STARS-Design-Track-2023/Teenage-Mixing-Ninja-Turtles/docs/pinout.drawio.png

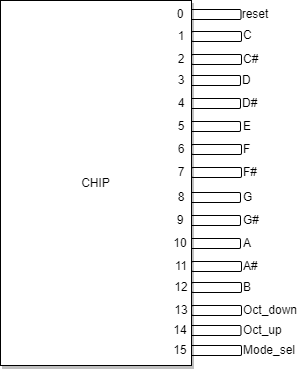
docs/pinout.drawio.png
