STARS-Design-Track-2023/Teenage-Mixing-Ninja-Turtles/docs/Scankey.drawio.png

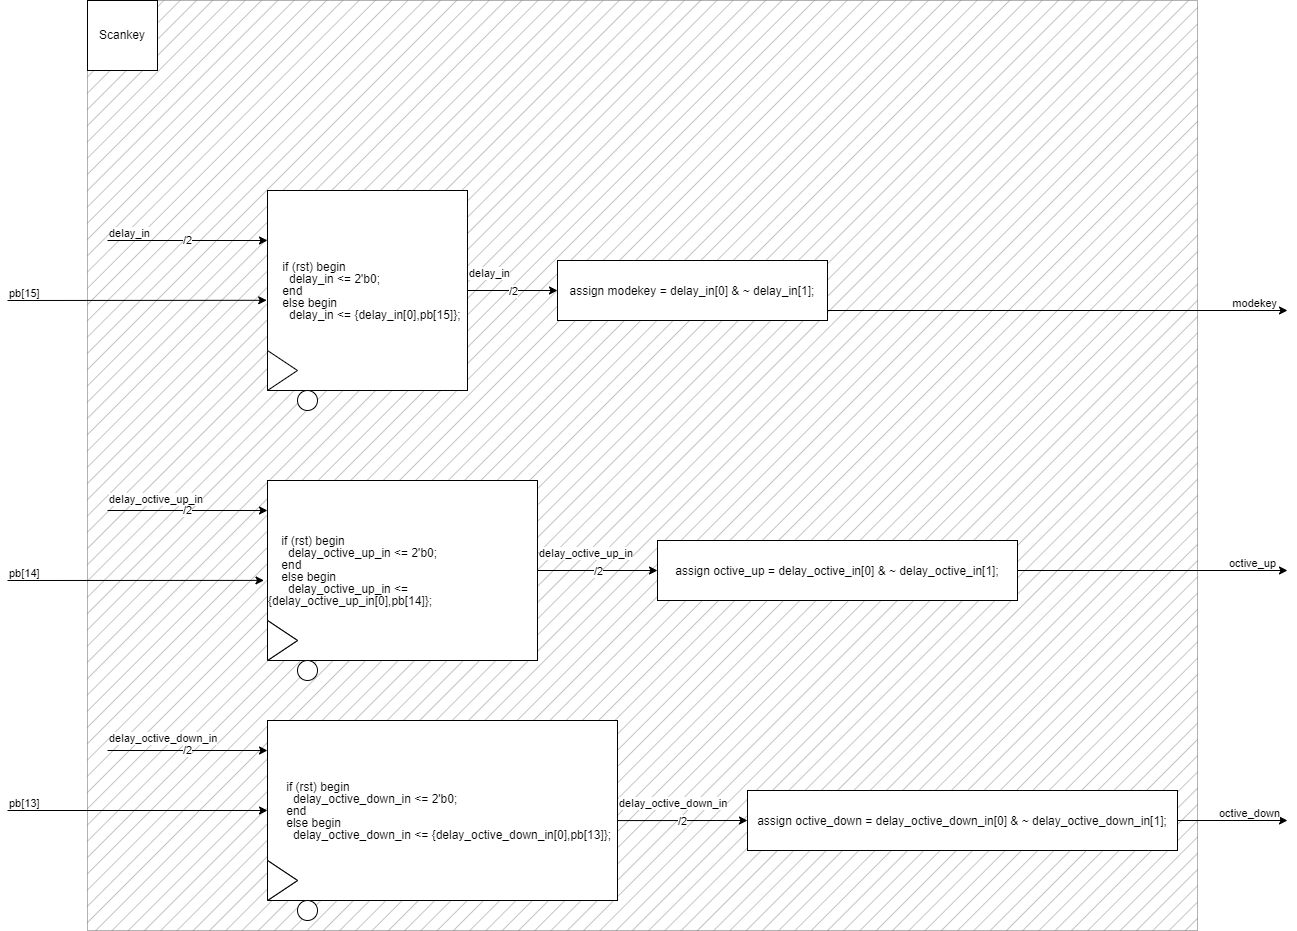
docs/Scankey.drawio.png
