STARS-Design-Track-2023/Teenage-Mixing-Ninja-Turtles/docs/STARS Design Review.pdf

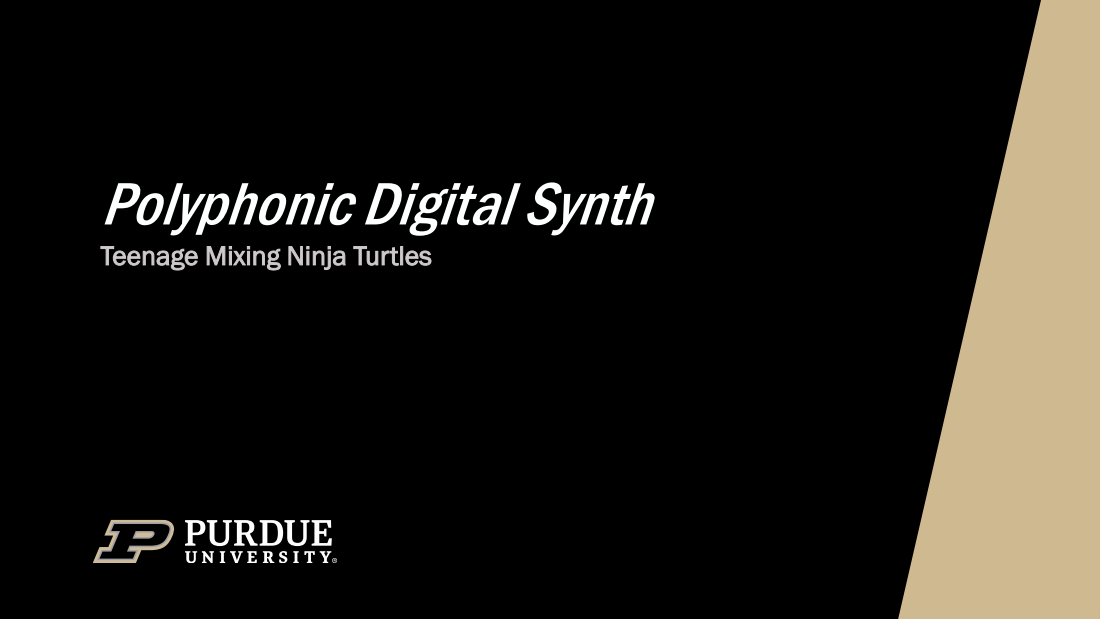
[picture p16: page 1]

Polyphonic Digital Synth

Teenage Mixing Ninja Turtles

# Goal of the Design

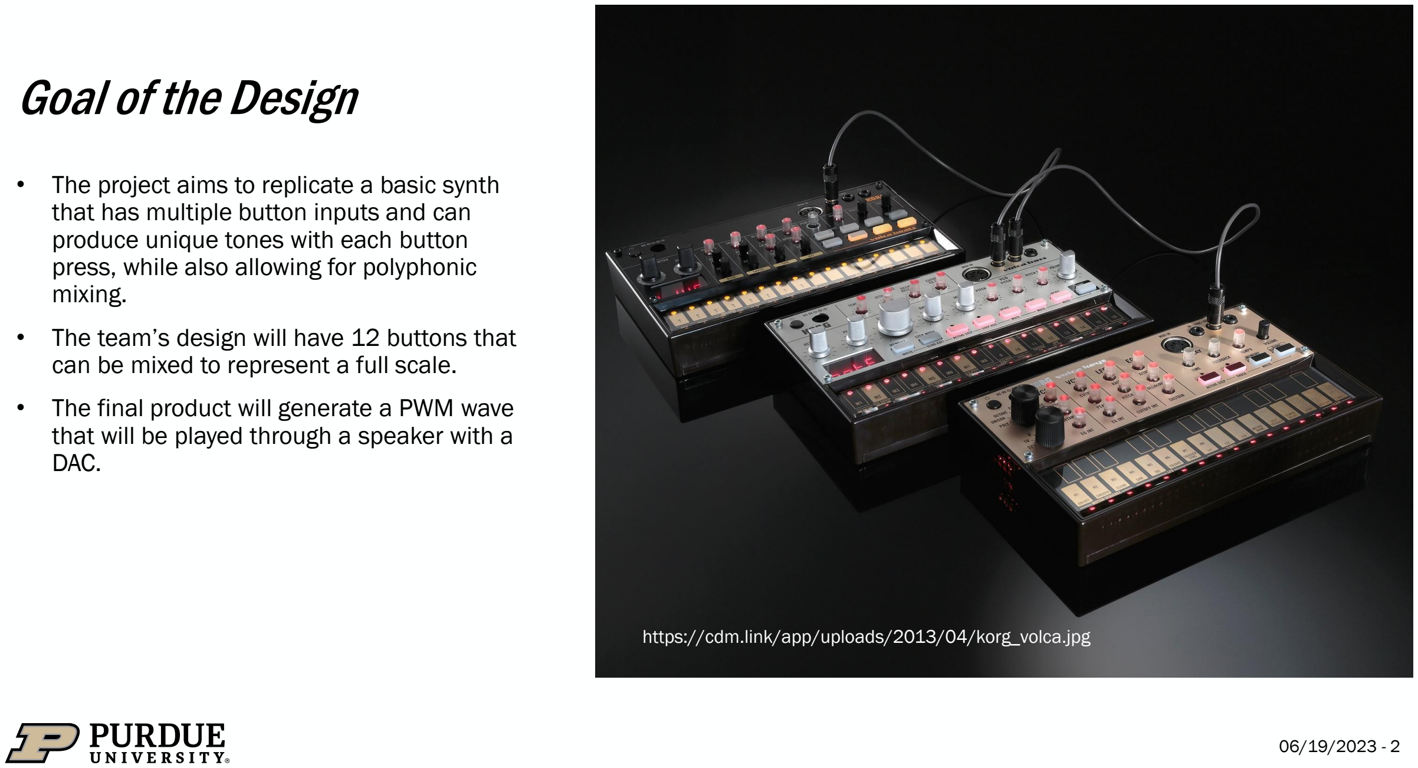
[picture p17: page 2]

- The project aims to replicate a basic synth that has multiple button inputs and can produce unique tones with each button press, while also allowing for polyphonic mixing.
- The team’s design will have 12 buttons that can be mixed to represent a full scale.
- The final product will generate a PWM wave that will be played through a speaker with a DAC.

https://cdm.link/app/uploads/2013/04/korg_volca.jpg

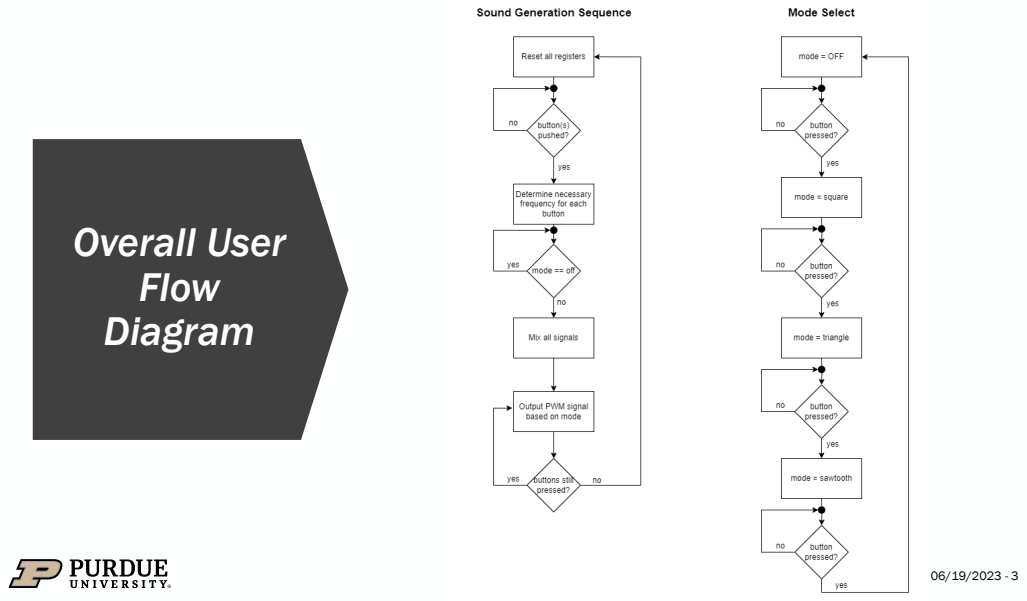
[picture p18: page 3]
Overall User Flow Diagram

Overview | RTL Diagram

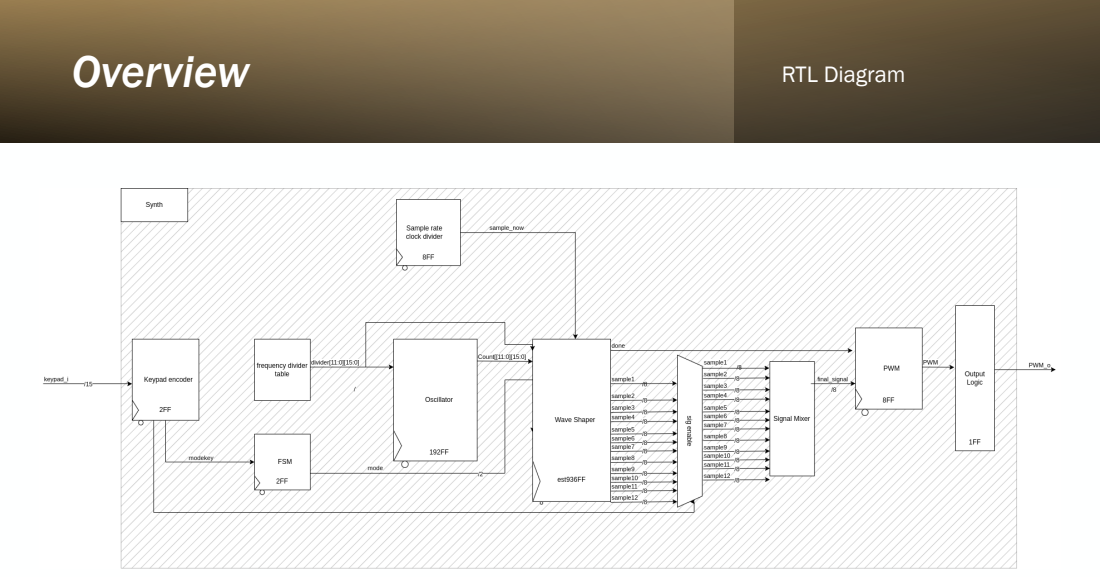
[picture p19: page 4]

Keypad | RTL

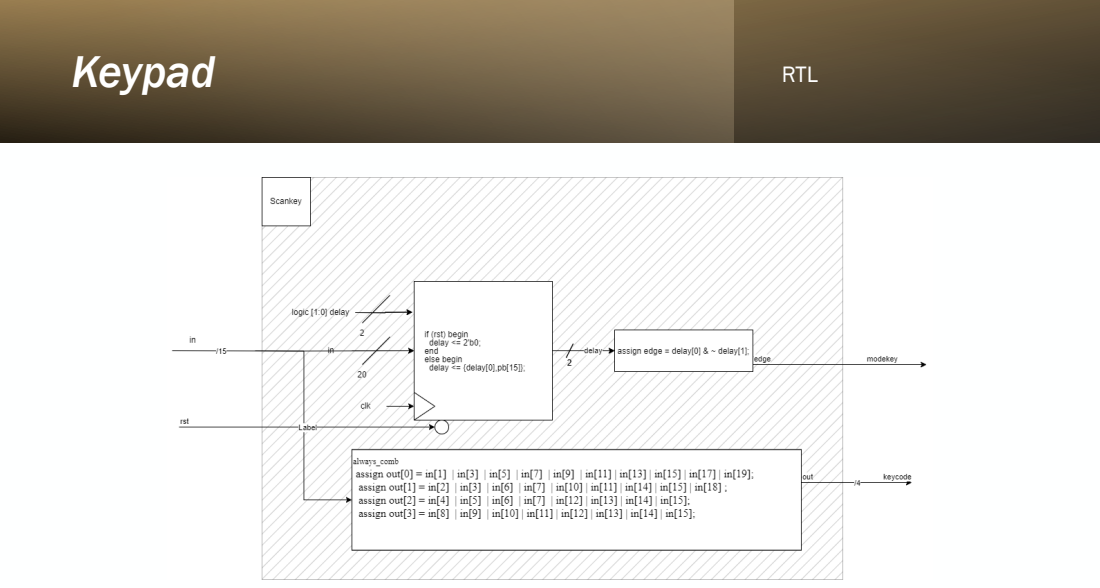
[picture p20: page 5]

Keypad | Wavedrom

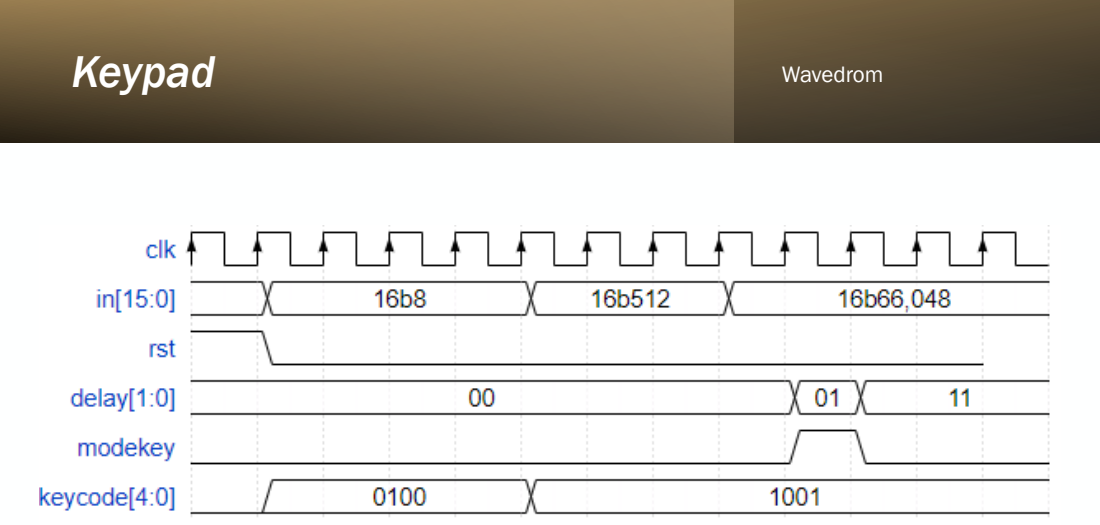
[picture p21: page 6]

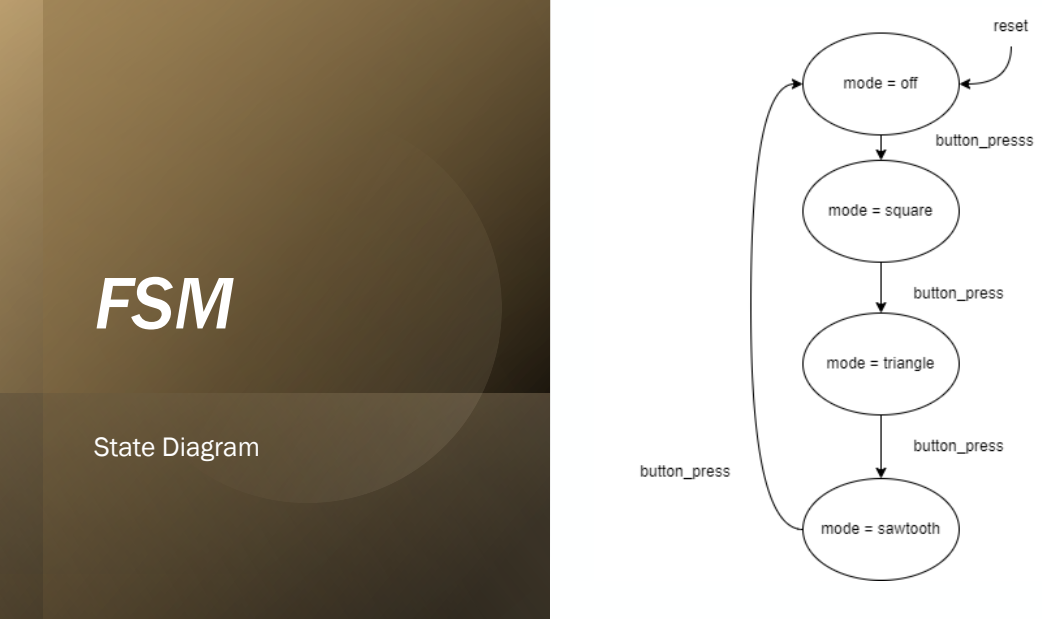
[picture p22: page 7]
FSM; State Diagram

# FSM

## Register

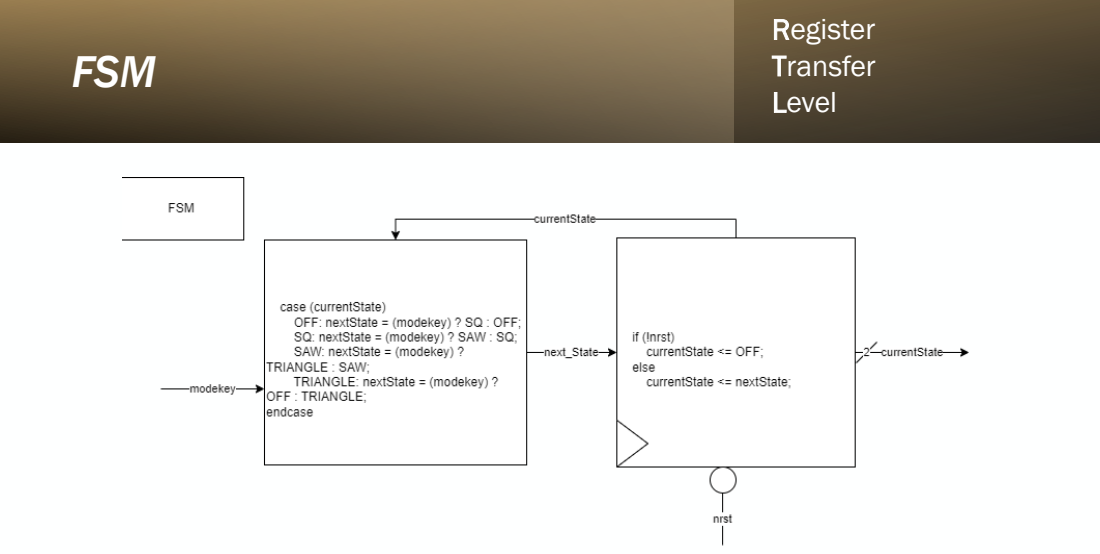
[picture p23: page 8]
Transfer Level

Oscillator | RTL

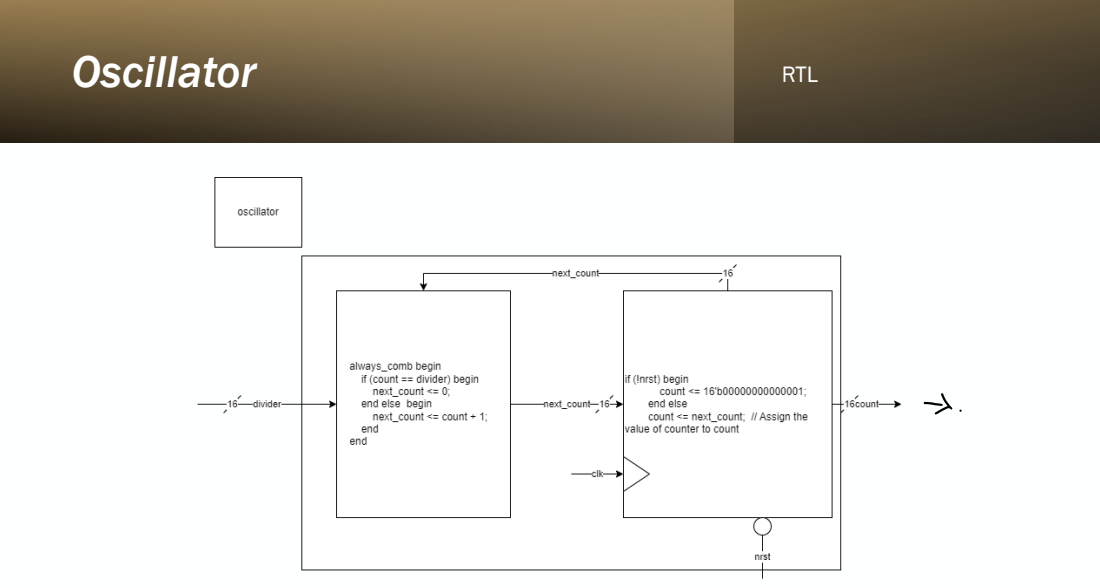
[picture p24: page 9]

Oscillator | Wavedrom

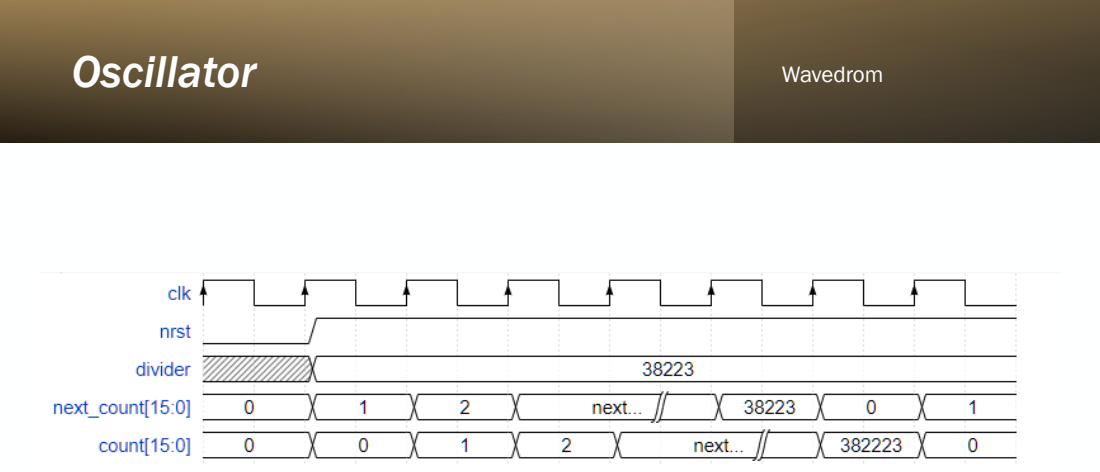
[picture p25: page 10]

Sample Rate ClkDiv | RTL

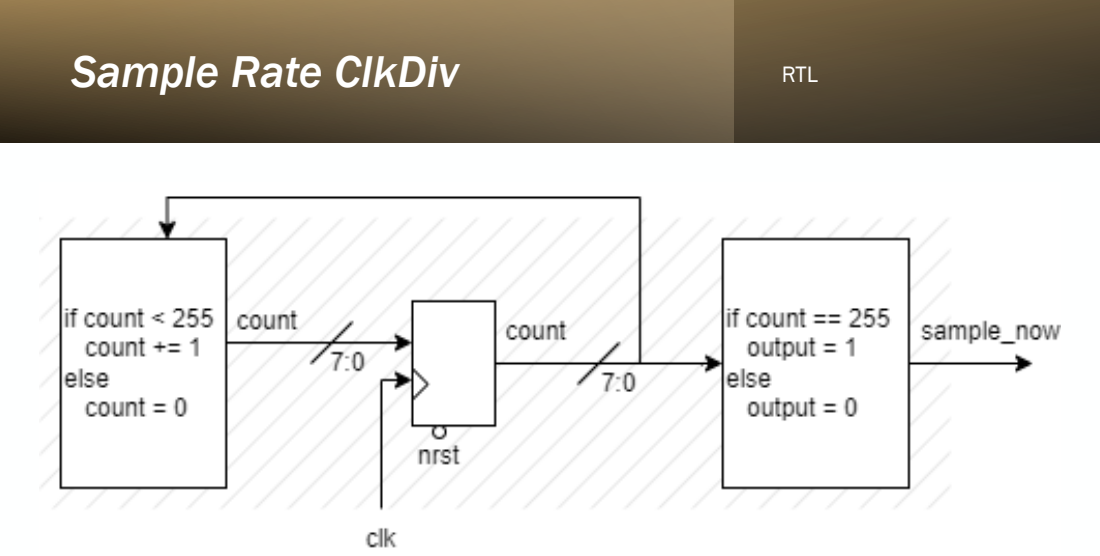
[picture p26: page 11]

# Sample Rate ClkDiv

## Wavedrom

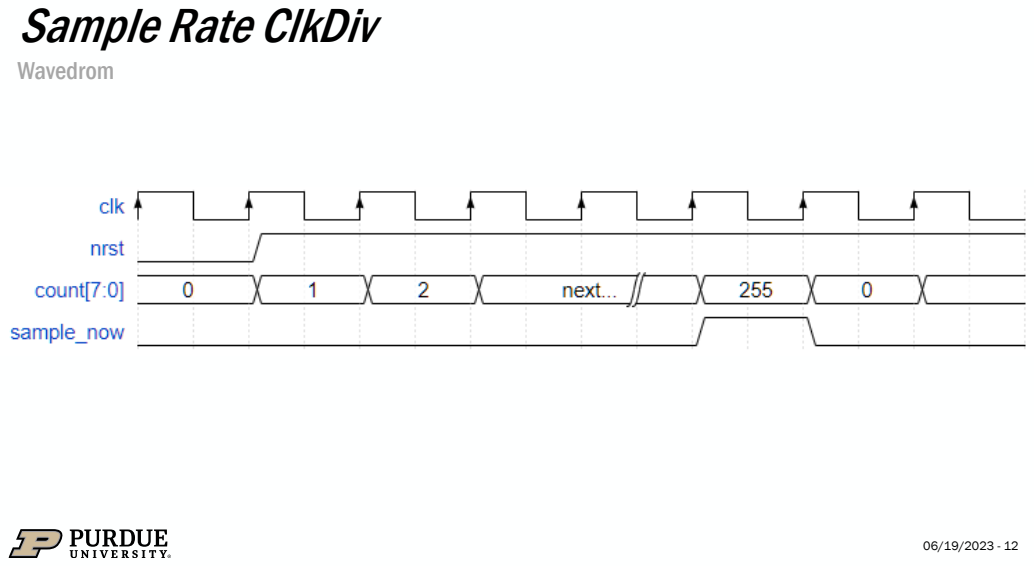
[picture p27: page 12]

# Wave Shaper

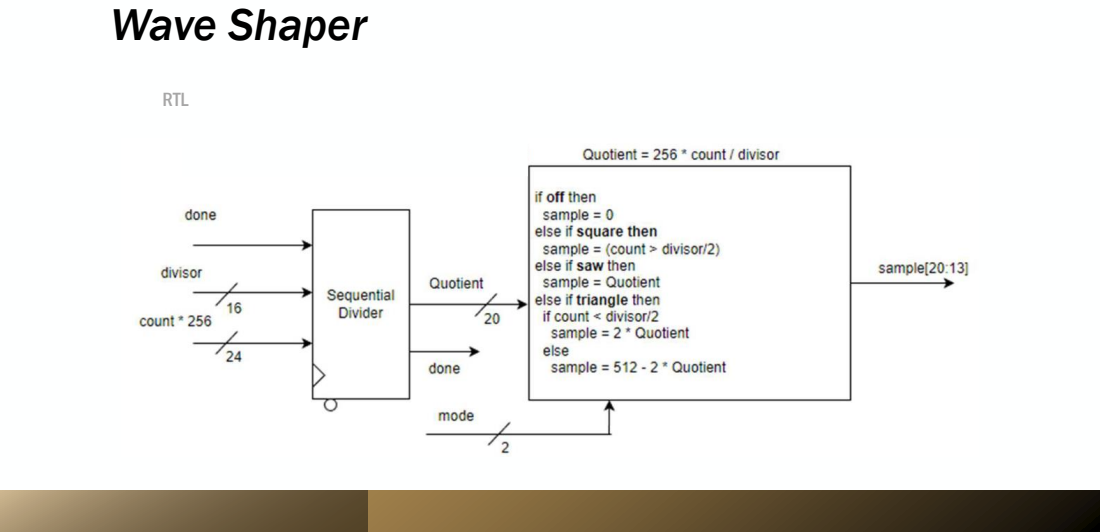
[picture p28: page 13]
RTL

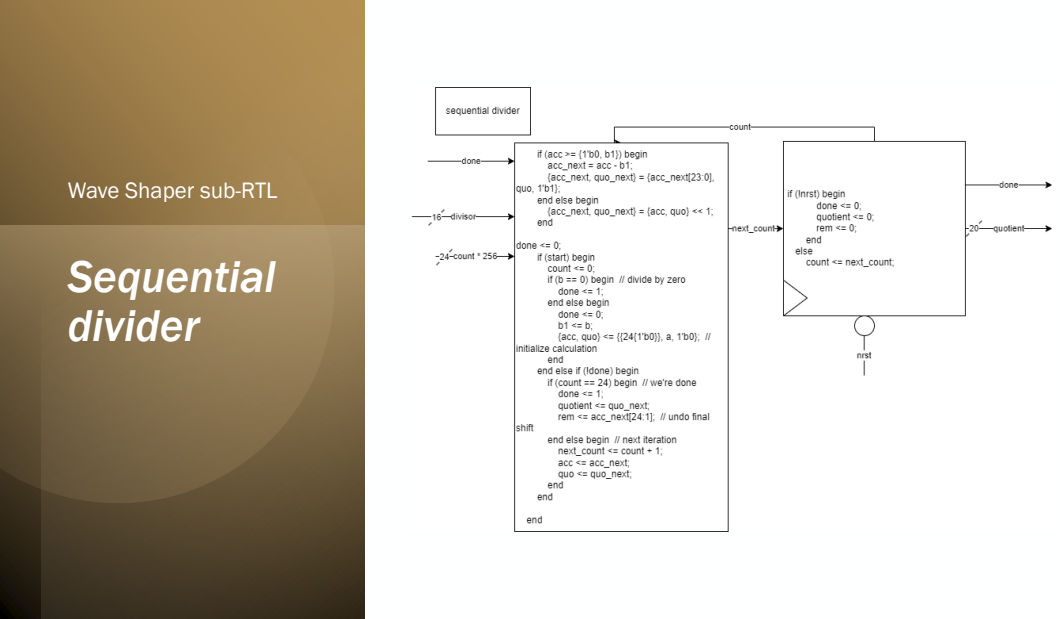
[picture p29: page 14]
Sequential divider

Wave Shaper sub-RTL

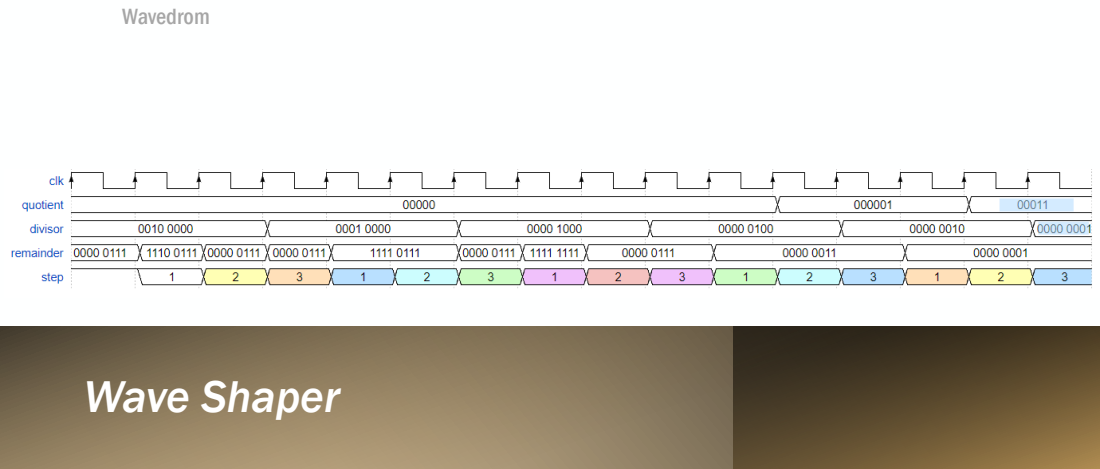
[picture p30: page 15]
Wave Shaper; Wavedrom

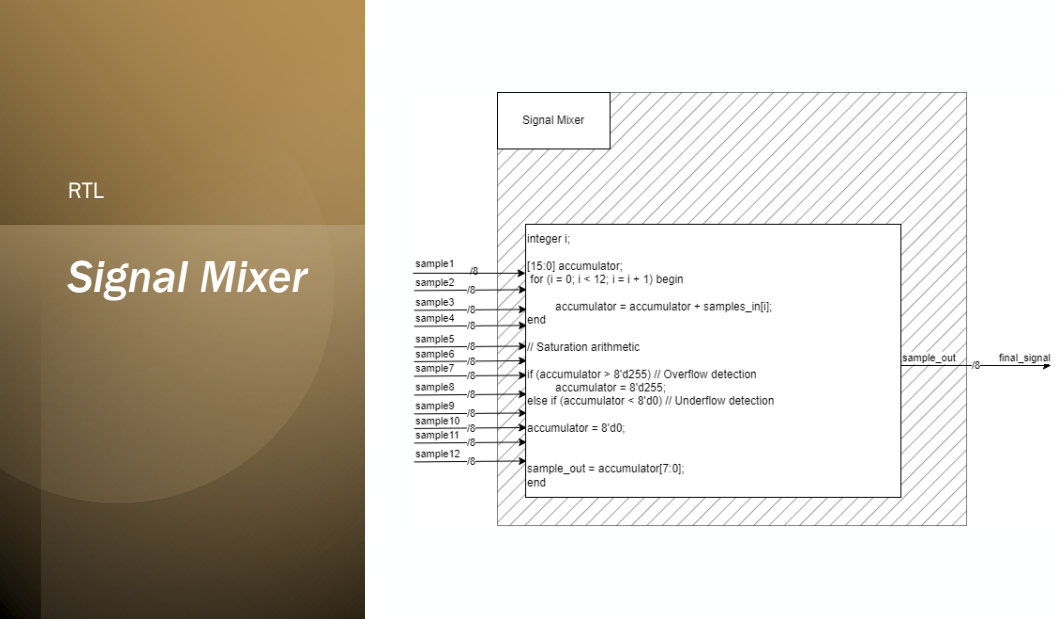
[picture p31: page 16]
Signal Mixer; RTL

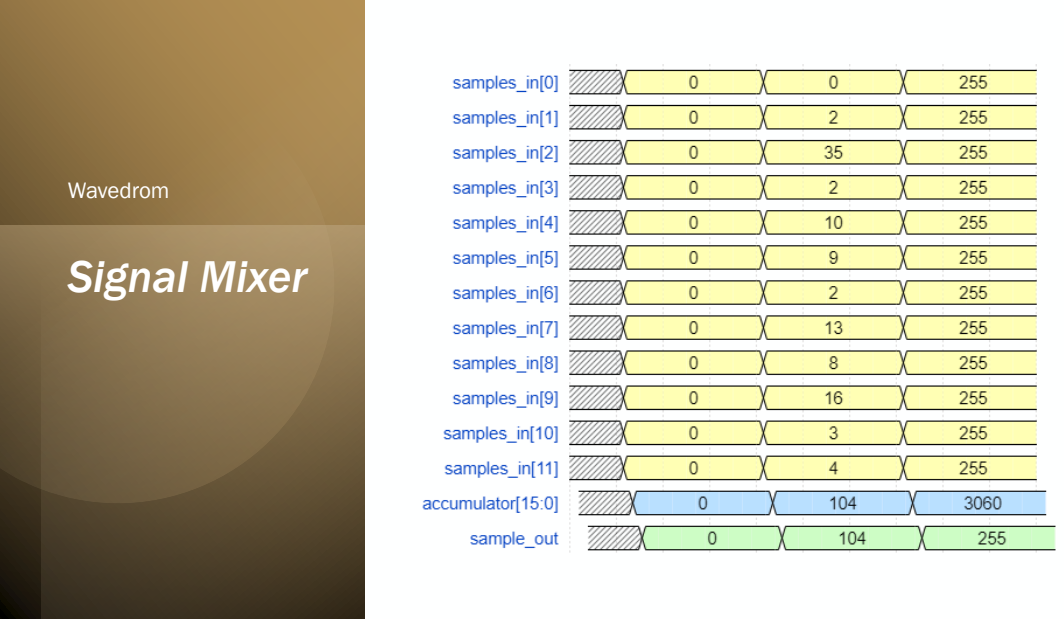
[picture p32: page 17]
Signal Mixer; Wavedrom

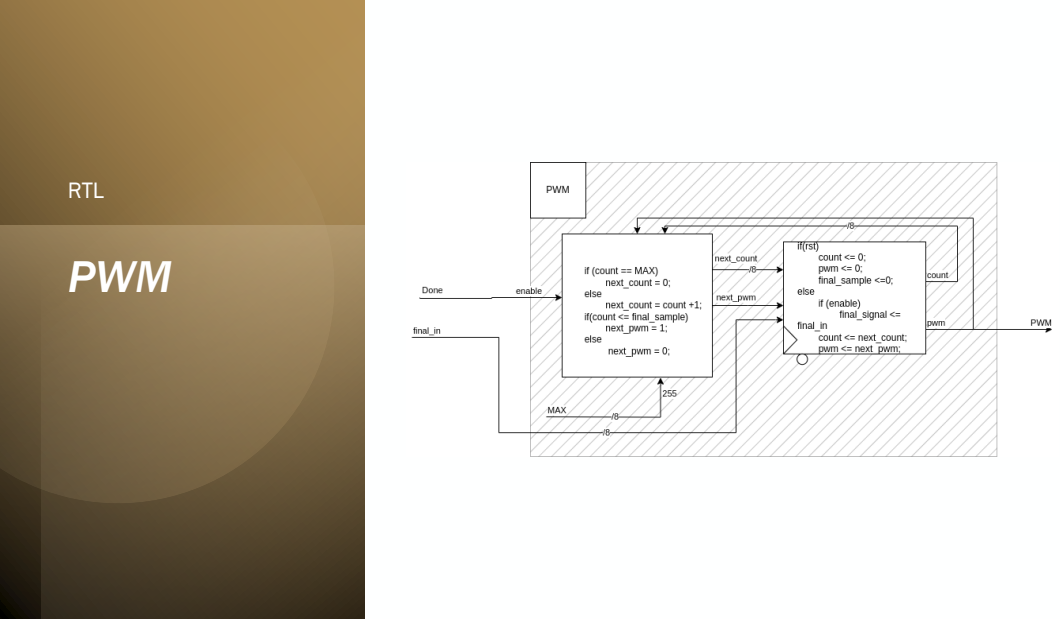
[picture p33: page 18]
PWM; RTL

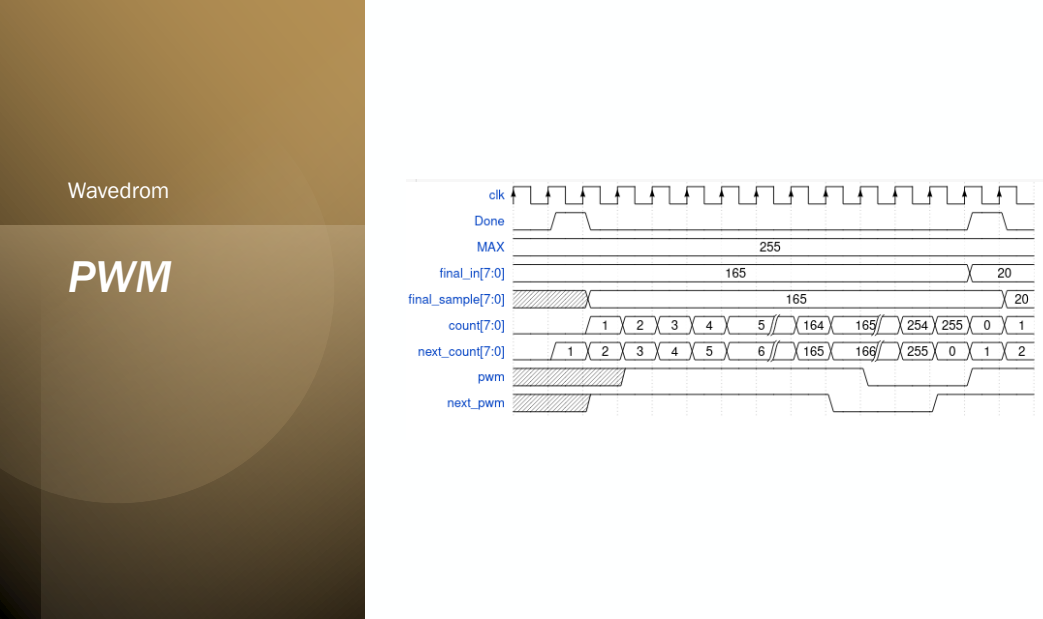
[picture p34: page 19]
PWM; Wavedrom

Module | Number of Flip-Flops
Keypad | 2

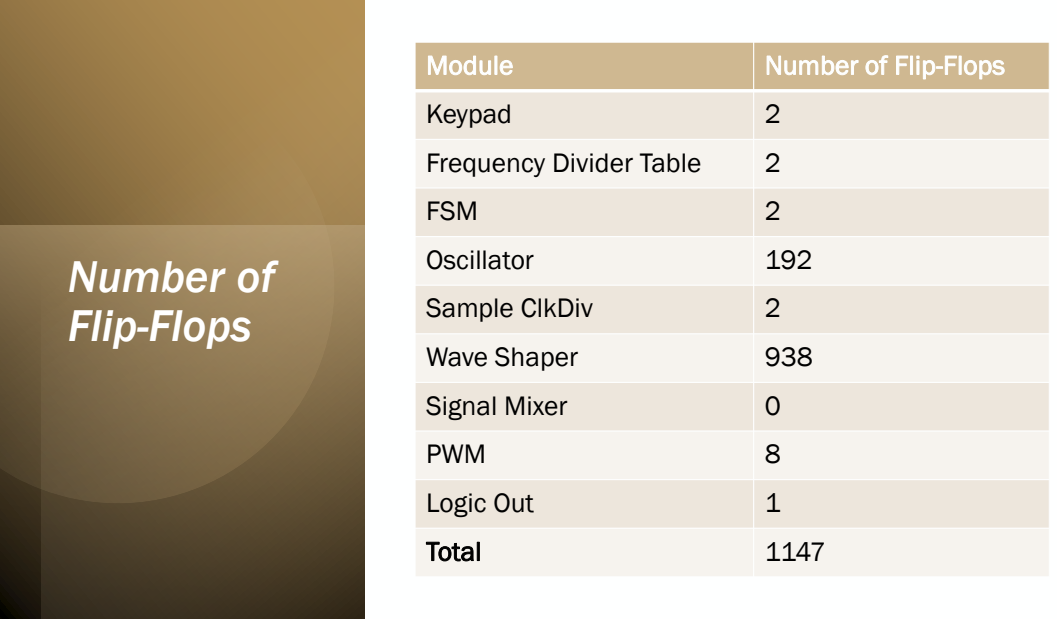
[picture p35: page 20]
Number of Flip-Flops

Frequency Divider Table | 2

FSM | 2

Oscillator | 192

Sample ClkDiv | 2

Wave Shaper | 938

Signal Mixer | 0

PWM | 8

Logic Out | 1

Total | 1147

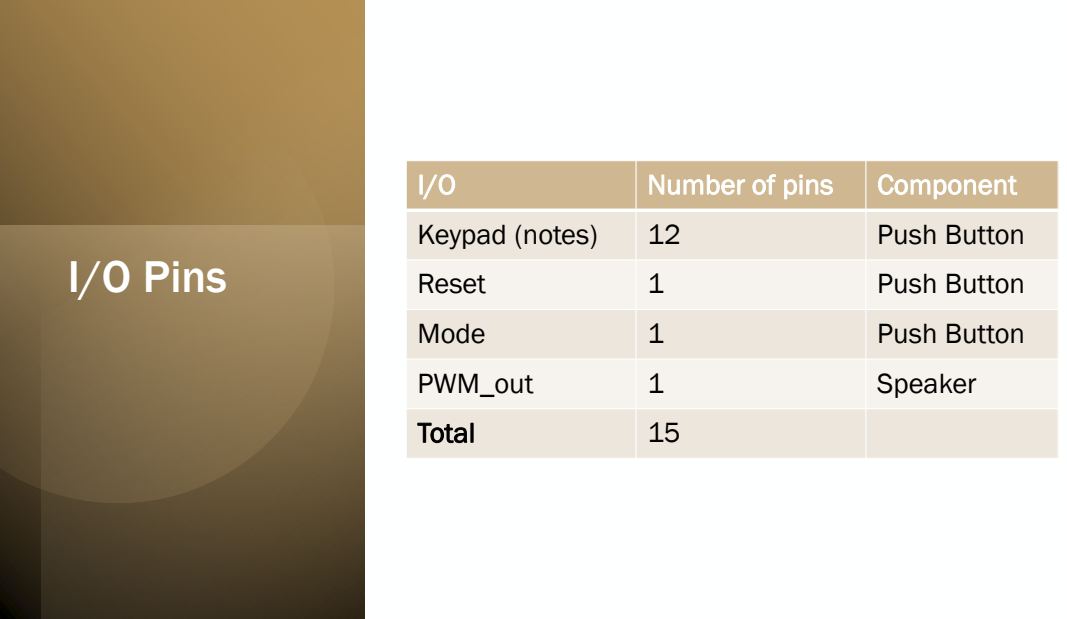
[picture p36: page 21]
I/O Pins

I/O | Number of pins | Component

Keypad (notes) | 12 | Push Button

Reset | 1 | Push Button

Mode | 1 | Push Button

PWM_out | 1 | Speaker

Total | 15
