STARS-Design-Track-2023/Teenage-Mixing-Ninja-Turtles/(commit log)

2023-06-20 INIT pwm, sigmix, keypad, top
2023-06-22 Changed edge to clock instead of button.
2023-06-23 fix fsm, add main, add wrap
    [top.sv]
2023-06-23 update make, sig_mix, sample_rate
2023-06-28 Wrapper and README updates (LED output)
